NozomiNetworks/NN-antenna-manager/hardware/fabrication/BOM.xlsx

Comment | Designator | Footprint | JLCPCB Part #（optional）
4u7 | C1,C2,C3,C4 | Capacitor_SMD:C_0603_1608Metric_Pad1.08x0.95mm_HandSolder | C19666
10uF | C5 | Capacitor_SMD:C_0805_2012Metric_Pad1.18x1.45mm_HandSolder | C1713
0.1uF | C6,C9,C10,C13,C14 | Capacitor_SMD:C_0603_1608Metric_Pad1.08x0.95mm_HandSolder | C66501
2u2 | C11 | Capacitor_SMD:C_0805_2012Metric_Pad1.18x1.45mm_HandSolder | C28234
100pF | C12 | Capacitor_SMD:C_0603_1608Metric_Pad1.08x0.95mm_HandSolder | C1853160
PESD5V0L1ULD | D1 | Diode_SMD:D_SOD-882 | C3001948
LED | D2,D3 | LED_SMD:LED_1206_3216Metric_Pad1.42x1.75mm_HandSolder | C965827
PE42482A-X | IC1 | PE42482A-X:QFN50P400X400X90-25N | C5121458
USB_C_Receptacle_USB2.0_16P | J1 | Connector_USB:USB_C_Receptacle_G-Switch_GT-USB-7010ASV | C2988369
Conn_Coaxial | J2,J3,J4,J5,J6,J7,J8,J9,J10 | Connector_Coaxial:SMA_Amphenol_132289_EdgeMount | C3172723
5k1 | R1,R2 | Resistor_SMD:R_0603_1608Metric_Pad0.98x0.95mm_HandSolder | C23186
0R | R3 | Resistor_SMD:R_0805_2012Metric_Pad1.20x1.40mm_HandSolder | C17477
10K | R5,R6,R7,R8,R9,R14,R15,R16,R17 | Resistor_SMD:R_0603_1608Metric_Pad0.98x0.95mm_HandSolder | C25804
220R | R10 | Resistor_SMD:R_0603_1608Metric_Pad0.98x0.95mm_HandSolder | C22962
480R | R11 | Resistor_SMD:R_0603_1608Metric_Pad0.98x0.95mm_HandSolder | C23179
SW_Push | SW1,SW2 | Button_Switch_SMD:SW_SPST_B3U-1000P | C231329
Button_up | SW3 | Button_Switch_SMD:SW_SPST_B3U-1000P | C231329
Button_down | SW4 | Button_Switch_SMD:SW_SPST_B3U-1000P | C231329
USBLC6-2SC6 | U1 | Package_TO_SOT_SMD:SOT-23-6 | C2687116
AP2112K-3.3 | U2 | Package_TO_SOT_SMD:SOT-23-5_HandSoldering | C51118
ESP32-C3-WROOM-02 | U3 | RF_Module:ESP32-C3-WROOM-02 | C2934560
