NozomiNetworks/NN-antenna-manager/hardware/kicad_project/NN-antenna-manager.kicad_pcb

## KiCad design hardware/kicad_project/NN-antenna-manager.kicad_pcb (2026-09-24)

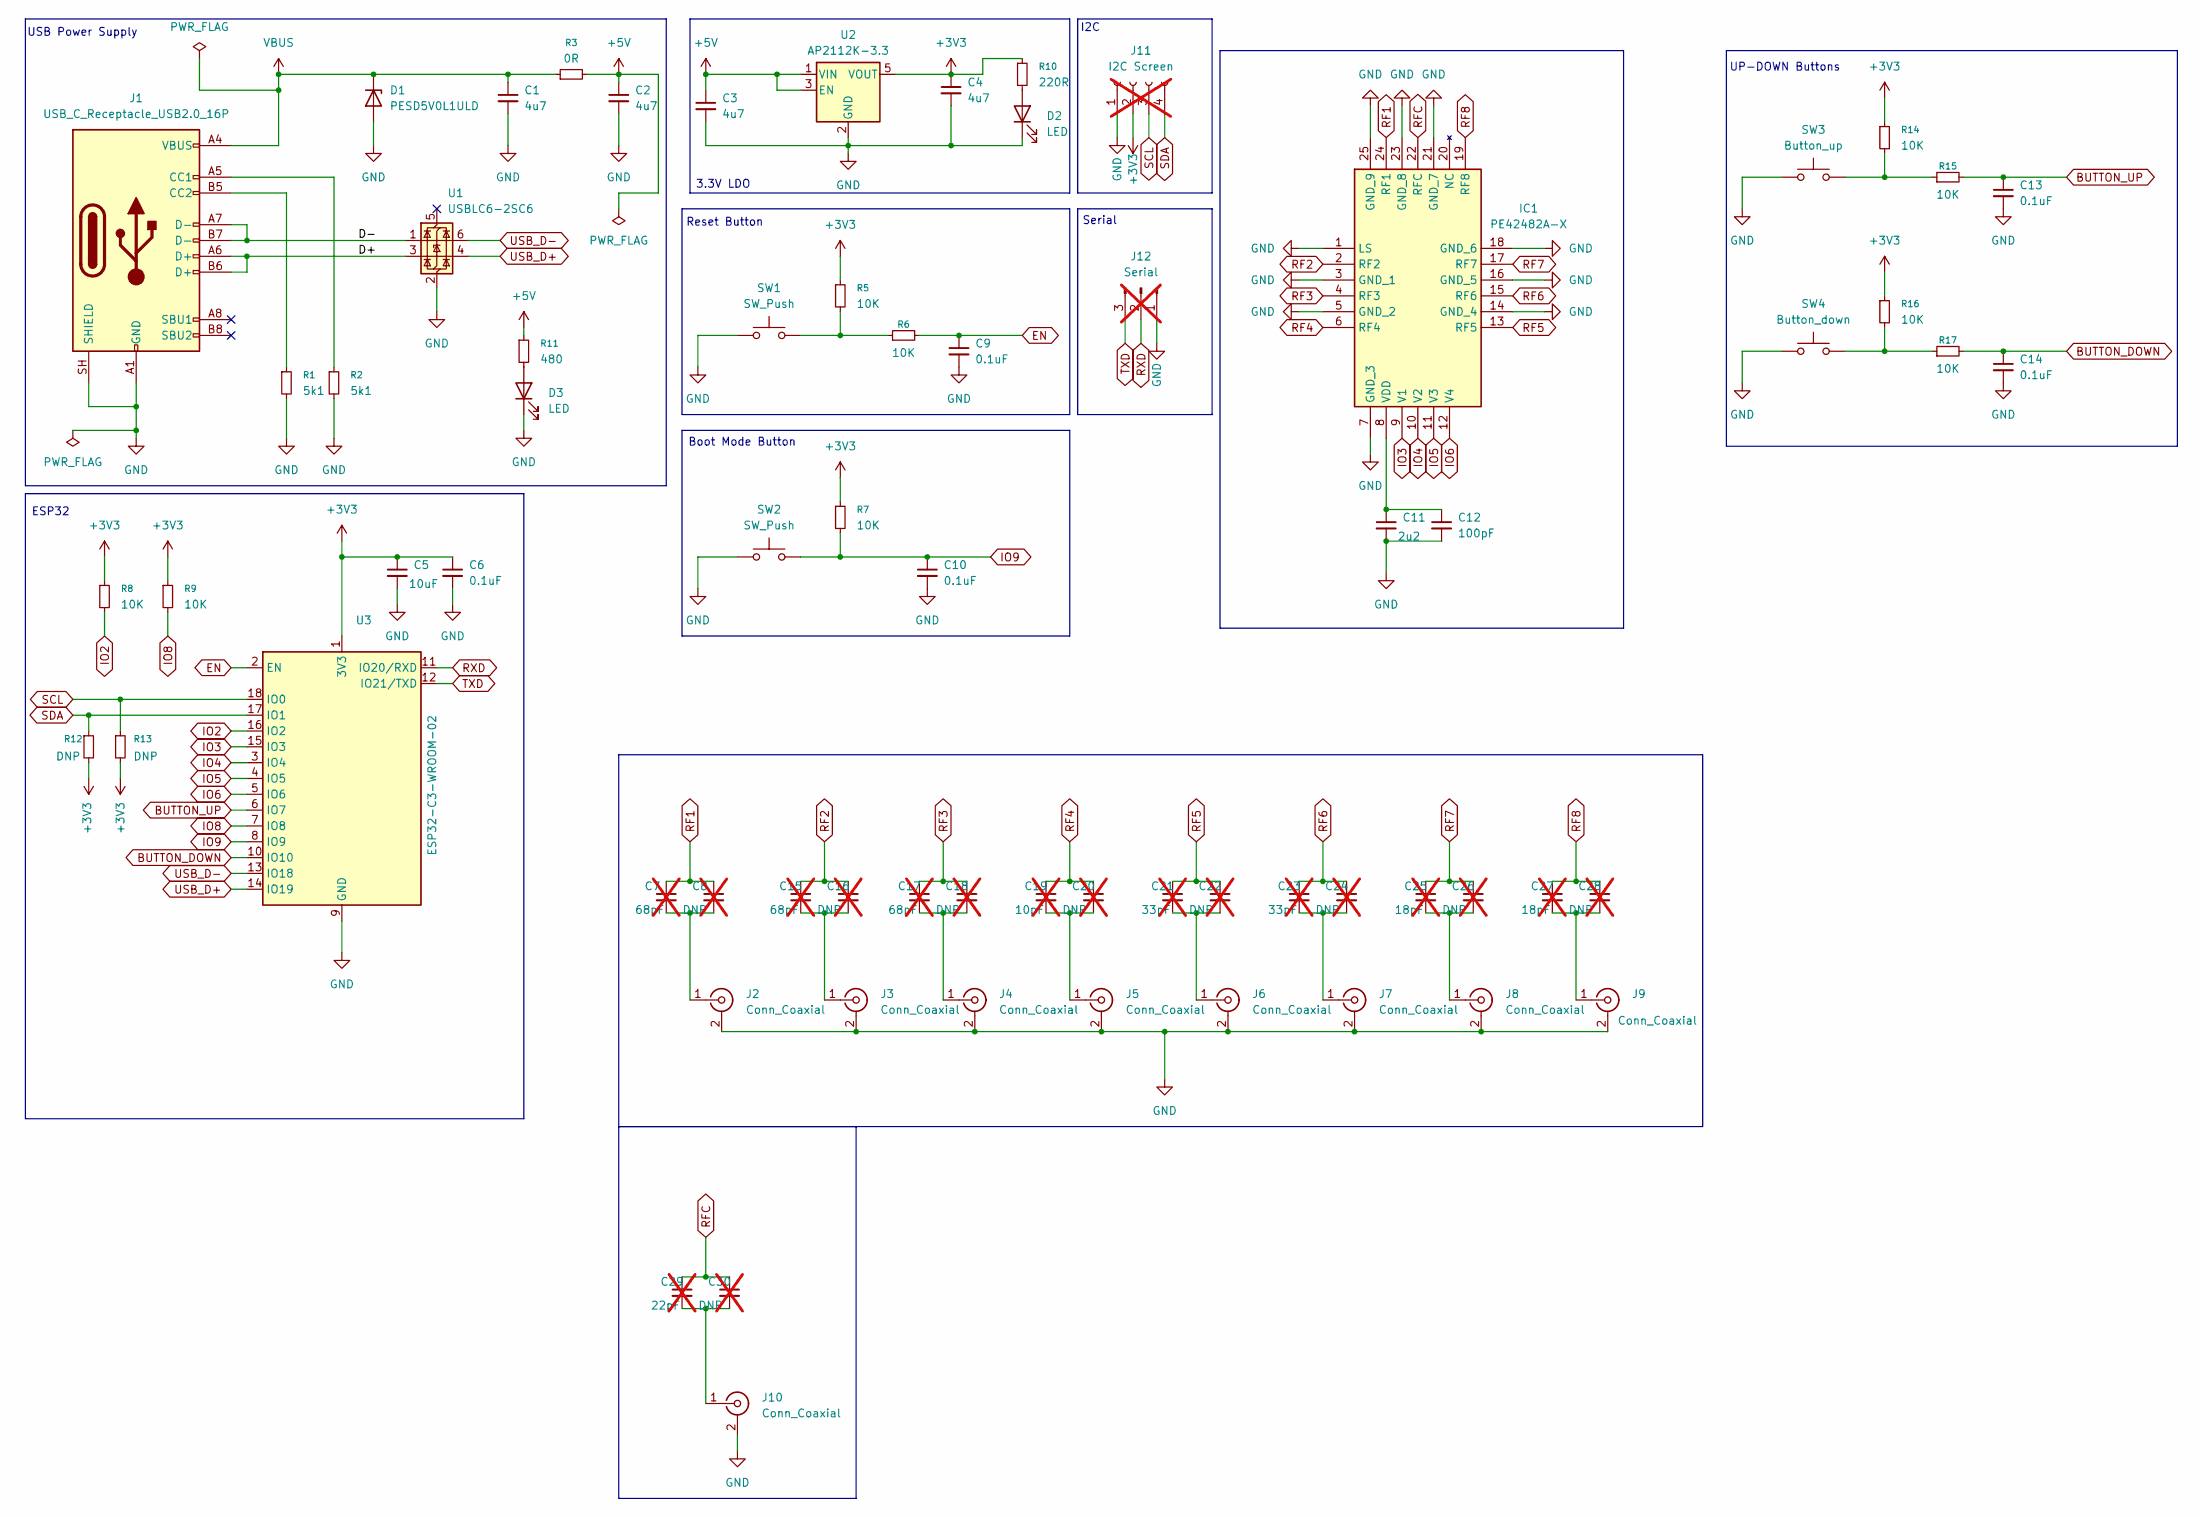
[picture p1: schematic NN-antenna-manager.kicad_sch]

Parts:
C1, C2, C3, C4: 4u7; C_0603_1608Metric_Pad1.08x0.95mm_HandSolder; JLCPCB Part# C19666
C5: 10uF; C_0805_2012Metric_Pad1.18x1.45mm_HandSolder; JLCPCB Part# C1713
C6, C9, C10, C13, C14: 0.1uF; C_0603_1608Metric_Pad1.08x0.95mm_HandSolder; JLCPCB Part# C66501
C7, C15, C17: 68pF; C_0402_1005Metric_Pad0.74x0.62mm_HandSolder; JLCPCB Part# DNP; not fitted
C8, C16, C18, C20, C22, C24, C26, C28, C30: DNP; C_0402_1005Metric_Pad0.74x0.62mm_HandSolder; JLCPCB Part# DNP; not fitted
C11: 2u2; C_0805_2012Metric_Pad1.18x1.45mm_HandSolder; JLCPCB Part# C28234
C12: 100pF; C_0603_1608Metric_Pad1.08x0.95mm_HandSolder; JLCPCB Part# C1853160
C19: 10pF; C_0402_1005Metric_Pad0.74x0.62mm_HandSolder; JLCPCB Part# DNP; not fitted
C21, C23: 33pF; C_0402_1005Metric_Pad0.74x0.62mm_HandSolder; JLCPCB Part# DNP; not fitted
C25, C27: 18pF; C_0402_1005Metric_Pad0.74x0.62mm_HandSolder; JLCPCB Part# DNP; not fitted
C29: 22pF; C_0402_1005Metric_Pad0.74x0.62mm_HandSolder; JLCPCB Part# DNP; not fitted
D1: PESD5V0L1ULD; D_SOD-882; JLCPCB Part# C3001948
D2, D3: LED; LED_1206_3216Metric_Pad1.42x1.75mm_HandSolder; JLCPCB Part# C965827
IC1: PE42482A-X; QFN50P400X400X90-25N; Manufacturer_Part_Number PE42482A-X; Mouser Part Number 81-PE42482A-X
J1: USB_C_Receptacle_USB2.0_16P; USB_C_Receptacle_G-Switch_GT-USB-7010ASV; JLCPCB Part# C2988369
J2, J3, J4, J5, J6, J7, J8, J9, J10: Conn_Coaxial; SMA_Amphenol_132289_EdgeMount; JLCPCB Part# C3172723
J11: I2C Screen; PinSocket_1x04_P2.54mm_Vertical; JLCPCB Part# DNP; not fitted
J12: Serial; PinHeader_1x03_P2.54mm_Vertical; JLCPCB Part# DNP; not fitted
R1, R2: 5k1; R_0603_1608Metric_Pad0.98x0.95mm_HandSolder; JLCPCB Part# C23186
R3: 0R; R_0805_2012Metric_Pad1.20x1.40mm_HandSolder; JLCPCB Part# C17477
R5, R6, R7, R8, R9, R14, R15, R16, R17: 10K; R_0603_1608Metric_Pad0.98x0.95mm_HandSolder; JLCPCB Part# C25804
R10: 220R; R_0603_1608Metric_Pad0.98x0.95mm_HandSolder; JLCPCB Part# C22962
R11: 480; R_0603_1608Metric_Pad0.98x0.95mm_HandSolder; JLCPCB Part# C23179
R12, R13: DNP; R_0603_1608Metric_Pad0.98x0.95mm_HandSolder; JLCPCB Part# DNP
SW1, SW2: SW_Push; SW_SPST_B3U-1000P; JLCPCB Part# C231329
SW3: Button_up; SW_SPST_B3U-1000P; JLCPCB Part# C231329
SW4: Button_down; SW_SPST_B3U-1000P; JLCPCB Part# C231329
U1: USBLC6-2SC6; SOT-23-6; JLCPCB Part# C2687116
U2: AP2112K-3.3; SOT-23-5_HandSoldering; JLCPCB Part# C51118
U3: ESP32-C3-WROOM-02; JLCPCB Part# C2934560

Connections:
+3V3: C4.1, C5.1, C6.1, J11.2, R5.1, R7.1, R8.1, R9.1, R10.1, R12.2, R13.2, R14.1, R16.1, U2.5 (VOUT), U3.1 (3V3)
+5V: C2.1, C3.1, R3.2, R11.1, U2.1 (VIN), U2.3 (EN)
/D+: J1.A6 (D+), J1.B6 (D+), U1.3 (I/O2)
/D-: J1.A7 (D-), J1.B7 (D-), U1.1 (I/O1)
BUTTON_DOWN: C14.1, R17.2, U3.10 (IO10)
BUTTON_UP: C13.1, R15.2, U3.6 (IO7)
EN: C9.1, R6.2, U3.2 (EN)
GND: C1.2, C2.2, C3.2, C4.2, C5.2, C6.2, C9.2, C10.2, C11.2, C12.2, C13.2, C14.2, D1.2 (A), D2.1 (K), D3.1 (K), IC1.1 (LS), IC1.3 (GND_1), IC1.5 (GND_2), IC1.7 (GND_3), IC1.14 (GND_4), IC1.16 (GND_5), IC1.18 (GND_6), IC1.21 (GND_7), IC1.23 (GND_8), IC1.25 (GND_9), J1.A1 (GND), J1.A12 (GND), J1.B1 (GND), J1.B12 (GND), J1.SH (SHIELD), J2.2 (Ext), J3.2 (Ext), J4.2 (Ext), J5.2 (Ext), J6.2 (Ext), J7.2 (Ext), J8.2 (Ext), J9.2 (Ext), J10.2 (Ext), J11.1, J12.1, R1.2, R2.2, SW1.1, SW2.1, SW3.1, SW4.1, U1.2 (GND), U2.2 (GND), U3.9 (GND), U3.19 (GND)
IO2: R8.2, U3.16 (IO2)
IO3: IC1.9 (V1), U3.15 (IO3)
IO4: IC1.10 (V2), U3.3 (IO4)
IO5: IC1.11 (V3), U3.4 (IO5)
IO6: IC1.12 (V4), U3.5 (IO6)
IO8: R9.2, U3.7 (IO8)
IO9: C10.1, R7.2, SW2.2, U3.8 (IO9)
unnamed: D2.2 (A), R10.2
unnamed: D3.2 (A), R11.2
unnamed: C11.1, C12.1, IC1.8 (VDD)
unnamed: J1.A5 (CC1), R2.1
unnamed: J1.B5 (CC2), R1.1
unnamed: C7.2, C8.2, J2.1 (In)
unnamed: C15.2, C16.2, J3.1 (In)
unnamed: C17.2, C18.2, J4.1 (In)
unnamed: C19.2, C20.2, J5.1 (In)
unnamed: C21.2, C22.2, J6.1 (In)
unnamed: C23.2, C24.2, J7.1 (In)
unnamed: C25.2, C26.2, J8.1 (In)
unnamed: C27.2, C28.2, J9.1 (In)
unnamed: C29.2, C30.2, J10.1 (In)
unnamed: R5.2, R6.1, SW1.2
unnamed: R14.2, R15.1, SW3.2
unnamed: R16.2, R17.1, SW4.2
RF1: C7.1, C8.1, IC1.24 (RF1)
RF2: C15.1, C16.1, IC1.2 (RF2)
RF3: C17.1, C18.1, IC1.4 (RF3)
RF4: C19.1, C20.1, IC1.6 (RF4)
RF5: C21.1, C22.1, IC1.13 (RF5)
RF6: C23.1, C24.1, IC1.15 (RF6)
RF7: C25.1, C26.1, IC1.17 (RF7)
RF8: C27.1, C28.1, IC1.19 (RF8)
RFC: C29.1, C30.1, IC1.22 (RFC)
RXD: J12.2, U3.11 (IO20/RXD)
SCL: J11.3, R13.1, U3.18 (IO0)
SDA: J11.4, R12.1, U3.17 (IO1)
TXD: J12.3, U3.12 (IO21/TXD)
USB_D+: U1.4 (I/O2), U3.14 (IO19)
USB_D-: U1.6 (I/O1), U3.13 (IO18)
VBUS: C1.1, D1.1 (K), J1.A4 (VBUS), J1.A9 (VBUS), J1.B4 (VBUS), J1.B9 (VBUS), R3.1

Notes on the sheet:
ESP32
USB Power Supply
I2C
Boot Mode Button
3.3V LDO
Serial
Reset Button
UP-DOWN Buttons

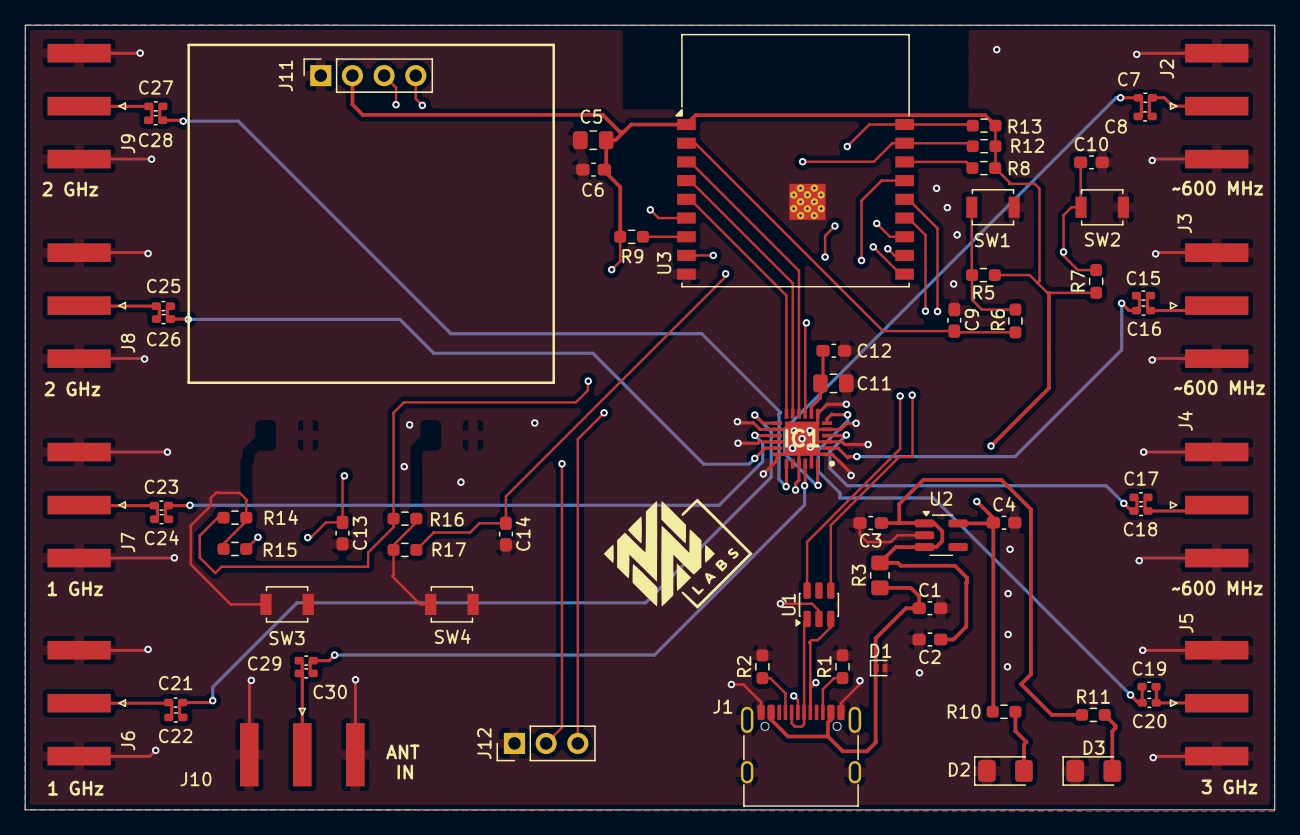
[picture p2: board NN-antenna-manager.kicad_pcb from above]

Board: 4 copper layers, 100.2 x 62.9 mm, 69 parts (0 on the bottom side), 48 nets.
