NozomiNetworks/NN-antenna-manager/(commit log)

2026-09-24 first commit - code and hardware design complete
    [BOM.xlsx, NN-antenna-manager.kicad_pcb, NN-antenna-manager.kicad_sch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]
2026-09-24 small fixes
    [NN-antenna-manager.kicad_pcb]
